cstapels/duckhouse/README.md

# duckhouse
controller for the duck house
