cstapels/duckhouse/duckboard/specificationDuck.md

Duck House Controller — Hardware Specification
Revision: 1.8 Purpose: ESP32-based controller for automated duck-house lift/door actuators, manual controls, environmental sensing, pump control, and battery monitoring.
1. System Overview
The controller operates from a nominal 12 V lead-acid battery and controls two 12 V linear actuators:
1. Lift actuator
2. Door actuator
Each actuator is controlled by an external BTS7960 / IBT-2 motor controller. Motor current does not pass through the PCB.
The PCB contains:
• ESP32U DevKit
• 12 V battery input and PCB protection
• External 5 V buck-converter interface
• Switched 5 V logic supply for the BTS7960 modules
• Four manual pushbuttons
• Three external limit switches
• Analog photosensor input
• Two travel-time adjustment potentiometers
• Battery-voltage measurement
• 1-Wire temperature sensor input
• Tank level input
• Pump control output (to an external driver)
• Status LED
• Connectors for all external devices
The ESP32's onboard regulator supplies the PCB's 3.3 V rail from the 5 V supply.
2. Battery Input and Power
J1 — Battery Input
2-pin, approximately 5.08 mm / 0.2" terminal block.
Pin
Signal
1
VBAT+
2
GND
Battery range:
• Nominal: 12 V
• Expected operating range: approximately 10.5–14.5 V
PCB Protection
Battery input sequence:
J1 → 8 A fuse → reverse-polarity protection → VBAT
The 8 A fuse protects the PCB/controller branch only.
The actuator motor power branches are separately fused and bypass the PCB.
Reverse Polarity
Use an N-channel MOSFET reverse-polarity protection arrangement.
Exact MOSFET/controller implementation remains TBD.
PCB Filtering
Provide:
• Bulk electrolytic capacitor near battery input
• Ceramic high-frequency bypass capacitor
• Optional TVS protection, value TBD
3. External 5 V Buck Converter
The 5 V supply is generated by an external buck converter.
J2 — Buck Converter
4-pin connector:
Pin
Signal
1
+5 V output
2
GND
3
VBAT input
4
ENABLE
Target:
• 5 V
• Up to approximately 2 A
Exact buck converter and ENABLE implementation TBD.
The 5 V supply powers:
• ESP32 DevKit
• BTS7960 logic supplies when enabled
• PCB 5 V output
4. ESP32
MCU
ESP32U DevKit / ESP32-WROOM-32U-class board.
The exact DevKit part will be finalized before the KiCad schematic is considered final.
The ESP32 DevKit's onboard regulator generates the 3.3 V rail.
No separate PCB 5 V-to-3.3 V regulator is required.
5. Corrected ESP32 GPIO Assignment
The following is the current baseline allocation.
Analog Inputs — ADC1
GPIO
Function
GPIO32
Battery voltage ADC
GPIO33
Lift travel-time potentiometer
GPIO36
Photosensor
GPIO39
Door travel-time potentiometer
All analog measurements use ADC1 so they remain compatible with ESP32 Wi-Fi operation.
GPIO36 and GPIO39 are input-only pins, which is acceptable for these measurements.
Motor Control
Lift
GPIO
Function
GPIO14
Lift Up / RPWM
GPIO12
Lift Down / LPWM
GPIO13
Lift Enable
Door
GPIO
Function
GPIO19
Door Open / RPWM
GPIO16
Door Close / LPWM
GPIO5
Door Enable
Each BTS7960 has its L_EN and R_EN tied together and controlled by the corresponding enable GPIO.
BTS7960 Logic Power
GPIO
Function
GPIO17
BTS7960 logic power switch
GPIO17 controls a discrete high-side 5 V switch.
High-Side Switch
27P04 P-channel MOSFET
• Source → +5 V
• Drain → MOTOR_CTRL_5V
• Gate → 30N06L drain
30N06L N-channel MOSFET
• Drain → 27P04 gate
• Source → GND
• Gate → GPIO17
Resistors:
• 100 kΩ from 27P04 gate to +5 V
• 10 kΩ from 30N06L gate to GND
Operation:
• GPIO17 LOW/floating → BTS7960 logic power OFF
• GPIO17 HIGH → BTS7960 logic power ON
The motor controllers' 12 V motor supply remains permanently connected to the external battery/motor-power wiring.
This switch controls only the BTS7960 logic supply.
6. ESP32 Boot/Strapping Pin Protection
Several application GPIOs are also ESP32 strapping pins. The PCB provides explicit external pulldowns so these signals have a predictable inactive state during reset and boot.
GPIO2 — Limit Switch Power
GPIO2 supplies power to the limit-switch circuits.
Add:
10 kΩ from GPIO2 to GND
Boot behavior:
• ESP32 reset/boot → GPIO2 LOW
• Firmware initialization → GPIO2 configured as output
• After initialization → GPIO2 driven HIGH when limit switches are being read
The limit switches therefore do not need to be powered during ESP32 startup.
GPIO5 — Door BTS7960 Enable
Add:
10 kΩ from GPIO5 to GND
This keeps the Door Enable signal LOW during reset/boot.
The BTS7960 logic supply is separately controlled by GPIO17 and remains OFF during startup.
GPIO12 — Lift BTS7960 LPWM
Add:
10 kΩ from GPIO12 to GND
This provides an explicit LOW state during reset/boot.
The BTS7960 logic supply is OFF during startup, so the motor controller cannot respond to the PWM signal during boot.
GPIO15 — Door Open Limit
The existing limit-switch input circuit already provides:
10 kΩ from GPIO15 to GND
This remains in place.
GPIO17 — BTS7960 Logic Power
The existing motor-logic power switch already provides:
10 kΩ from GPIO17 to GND
This guarantees that the 30N06L remains OFF while the ESP32 is resetting or booting.
GPIO23 — Pump Control
GPIO23 is not a strapping pin, but it is high-impedance during reset.
Add:
10 kΩ from GPIO23 to GND
This keeps the pump control signal LOW (pump OFF) during reset/boot.
Boot-State Resistor Summary
GPIO
Function
External pulldown
GPIO2
Limit-switch power
10 kΩ
GPIO5
Door BTS7960 enable
10 kΩ
GPIO12
Lift LPWM
10 kΩ
GPIO15
Door Open limit
10 kΩ
GPIO17
BTS7960 logic power
10 kΩ
GPIO23
Pump control
10 kΩ
GPIO0 is not used by the application and the ESP32 DevKit's existing BOOT circuitry should be retained.
Recommended Firmware Startup Sequence
The firmware should establish safe output states before enabling motor-controller logic:
1. ESP32 resets
2. GPIO2 remains LOW
3. GPIO5 remains LOW
4. GPIO12 remains LOW
5. GPIO14 remains LOW
6. GPIO16 remains LOW
7. GPIO19 remains LOW
8. GPIO13 remains LOW
9. GPIO17 remains LOW
10. GPIO23 remains LOW (pump OFF)
11. Configure GPIO directions and safe states
12. Initialize inputs/ADC
13. Start required communications
14. Drive GPIO17 HIGH to enable BTS7960 logic
15. Enable motor control and pump only when an intentional command is present
This ensures the motor controllers and pump driver cannot receive an unintended command during ESP32 startup.
7. Lift BTS7960 Interface
J3
Logic/control connector only.
Pin
Signal
1
MOTOR_CTRL_5V
2
GND
3
GPIO14 — Lift RPWM
4
GPIO12 — Lift LPWM
5
GPIO13 — Lift Enable
Motor power is external and does not enter the PCB.
8. Door BTS7960 Interface
J4
Logic/control connector only.
Pin
Signal
1
MOTOR_CTRL_5V
2
GND
3
GPIO19 — Door RPWM
4
GPIO16 — Door LPWM
5
GPIO5 — Door Enable
Motor power is external and does not enter the PCB.
9. Actuator Power
Two approximately 12 V linear actuators are used.
Current design target:
• Approximately 5 A specified operating current
• Approximately 6 A design maximum
• Exact startup/stall current not yet established
Each actuator receives power through its own external BTS7960.
Conceptually:
Battery → external fuse → BTS7960 → actuator
There will be no high-current actuator traces or motor connectors on the controller PCB.
Final external fuse sizes should be selected after measuring actual actuator startup/stall current and considering wire size.
10. Limit Switches
Three external limit switches are required:
1. Door Open
2. Door Close
3. Lift Close
There is no Lift Open limit switch in the current design.
Common Limit-Switch Power
GPIO2 supplies the limit-switch circuits.
GPIO2 is driven HIGH by firmware when the limit switches are being read.
Limit GPIO Assignment
GPIO
Function
GPIO15
Door Open
GPIO21
Door Close
GPIO25
Lift Close
Input Circuit
Each limit circuit uses:
GPIO2 → 470 Ω → switch wiring → limit switch → 470 Ω → sense GPIO
Each sense input has:
• 10 kΩ pulldown to GND
• 100 nF capacitor from GPIO to GND
Expected operation:
• Switch open → LOW
• Switch closed → HIGH
11. Pushbuttons
Four normally-open pushbuttons are used.
All are active HIGH.
Each button connects its GPIO to +3.3 V when pressed.
Each input has:
• External 10 kΩ pulldown to GND
• 100 nF capacitor from GPIO to GND
GPIO Assignment
GPIO
Button
GPIO34
Lift Close
GPIO35
Lift Open
GPIO18
Door Close
GPIO22
Door Open
12. Photosensor
The photosensor is an analog sensor.
Connections
• Supply → +3.3 V
• Ground → GND
• Analog output → GPIO36
No 5 V level shifting is required.
The photosensor is not powered through the BTS7960 logic-power switch.
Input filtering/protection remains TBD pending selection of the exact photosensor.
13. Travel-Time Potentiometers
Two potentiometers provide adjustable travel-time settings.
Target:
Bourns 3352E-1-105 or equivalent.
Requirements:
• 1 MΩ
• Single turn
• Through-hole
• Top-adjust
• 3 terminals
Lift Pot
• End 1 → +3.3 V
• End 2 → GND
• Wiper → GPIO33
• 100 nF wiper → GND
Door Pot
• End 1 → +3.3 V
• End 2 → GND
• Wiper → GPIO39
• 100 nF wiper → GND
Firmware should allow settling time and use multiple ADC readings/averaging.
14. Battery Voltage Measurement
Divider
• 2 MΩ from VBAT to ADC tap
• 100 kΩ from ADC tap to GND
• ADC tap → GPIO32
Nominal divider ratio:
21:1
Approximate ADC voltages:
Battery
ADC
10.5 V
0.500 V
12.0 V
0.571 V
14.5 V
0.690 V
A capacitor at the ADC tap should be considered to stabilize the measurement; exact value TBD.
15. Status LED
LED
• Blue
• SMD 3528
• 330 Ω series resistor
• Active HIGH
GPIO
GPIO4
Normal state:
OFF
Firmware uses the LED for:
• Startup indication
• Wi-Fi connection indication
• Other status indications as desired
15A. 1-Wire Temperature Sensor
A 1-Wire digital temperature sensor (DS18B20 or equivalent) is connected to GPIO26.
J13 — Temperature Sensor
3-pin connector:
Pin
Signal
1
+3.3 V
2
GPIO26 — 1-Wire DQ
3
GND
Circuit
• 4.7 kΩ pull-up from DQ to +3.3 V (2.2 kΩ if long cable; value TBD)
• 100–330 Ω series resistor between GPIO26 and J13 DQ (value TBD)
• Low-capacitance ESD/TVS diode on DQ at J13 (e.g., PESD5V0S1BL or similar)
• 100 nF decoupling capacitor between +3.3 V and GND at J13
• Optional 1–10 µF bulk capacitor at J13 for long cables
• Optional ferrite bead in the +3.3 V line to the sensor if noise is seen on long cable runs
• Avoid adding capacitance on the data line, as it slows 1-Wire edges
• Sensor is powered from the always-on +3.3 V rail (normal, non-parasitic power)
• Not powered through the BTS7960 logic-power switch
GPIO26 is not a strapping pin. Firmware uses a 1-Wire library (e.g., OneWire/DallasTemperature) with GPIO26 as the bus pin.
15B. Tank Level Input
Tank level input on GPIO27 (moved from GPIO26, which is now the 1-Wire temperature sensor).
J14 — Tank Level Input
Pin
Signal
1
+3.3 V
2
GPIO27 — Tank level
3
GND
Circuit
• Digital input (float switch or similar)
• 10 kΩ pulldown to GND
• 100 nF capacitor from GPIO27 to GND
• 330–470 Ω series resistor between connector and GPIO27
• Sensor supply from the always-on +3.3 V rail, not the switched MOTOR_CTRL_5V
• For a two-wire float switch, wire between pins 1 and 2 so the input goes HIGH when the switch closes (consistent with the pushbuttons)
• Firmware polarity (e.g., float up / tank full = HIGH) to be defined
GPIO27 is on ADC2, which is unavailable for analog reads while Wi-Fi is active. This is not a concern because the input is used digitally only. GPIO27 is not a strapping pin and has no boot-state concerns.
15C. Pump Control Output
GPIO23 provides the pump control signal (active HIGH) to an external pump driver.
J15 — Pump Control
Pin
Signal
1
GPIO23 — Pump control
2
GND
Circuit
• 10 kΩ pulldown from GPIO23 to GND, so the pump is OFF during ESP32 reset/boot
• 100–330 Ω series resistor between GPIO23 and J15 pin 1 (value TBD)
• Optional 100 nF capacitor from GPIO23 to GND
• Active HIGH: GPIO23 HIGH = pump ON, LOW = pump OFF
• Pump current does not pass through the PCB. The external driver switches the pump and has its own power wiring and fuse.
• The external driver's logic input must accept a 3.3 V signal.
GPIO23 is not a strapping pin and has no Wi-Fi conflicts.
16. 5 V Output
J11
2-pin 5 V output connector.
Pin
Signal
1
+5 V
2
GND
17. Connector Summary
Connector
Function
J1
Battery input
J2
External buck converter
J3
Lift BTS7960 logic/control
J4
Door BTS7960 logic/control
J5
Limit switches
J6
Lift Close button
J7
Lift Open button
J8
Door Close button
J9
Door Open button
J10
Photosensor
J11
5 V output
J12
Programming/debug — TBD
J13
1-Wire temperature sensor
J14
Tank level input
J15
Pump control
18. PCB Electrical Separation
Keep the following areas separated as much as practical:
High-current / noisy wiring
• Battery motor wiring
• BTS7960 motor outputs
• Actuator wiring
• Pump wiring and driver
These remain off-board.
Sensitive circuitry
• ESP32
• Battery ADC
• Photosensor ADC
• Travel potentiometer ADCs
• Pushbutton inputs
• Limit-switch inputs
• 1-Wire temperature sensor input
• Tank level input
Keep sensitive analog traces away from motor-controller wiring and switching nodes.
19. Decoupling and Filtering
Provide appropriate local bypass capacitors for:
• ESP32 5 V / 3.3 V supply
• BTS7960 logic supply connectors
• Photosensor supply
• Temperature sensor supply (J13)
• General PCB 3.3 V rail
• Battery input
Additional filtering:
• Pushbuttons: 100 nF
• Limit inputs: 100 nF
• Travel pots: 100 nF
• Tank level input: 100 nF
• Battery ADC: capacitor TBD
• Photosensor: filtering TBD
20. Current GPIO Map — MASTER TABLE
GPIO
Function
Type
2
Limit switch power
Output / strapping
4
Status LED
Output
5
Door BTS7960 enable
Output / strapping
12
Lift down / LPWM
Output / strapping
13
Lift enable
Output
14
Lift up / RPWM
Output
15
Door Open limit
Input / strapping
16
Door close / LPWM
Output
17
BTS7960 logic power
Output
18
Door Close button
Input
19
Door open / RPWM
Output
21
Door Close limit
Input
22
Door Open button
Input
23
Pump control
Output
25
Lift Close limit
Input
26
1-Wire temperature sensor
I/O
27
Tank level input
Input
32
Battery voltage
ADC1
33
Lift travel pot
ADC1
34
Lift Close button
Input
35
Lift Open button
Input
36
Photosensor
ADC1
39
Door travel pot
ADC1
GPIO6–11 remain reserved for ESP32 flash operation.
21. Open Design Items
Before PCB fabrication, finalize:
1. Exact ESP32U DevKit module
2. Reverse-polarity MOSFET circuit
3. Battery TVS selection
4. Battery input capacitor values
5. Exact external 5 V buck converter
6. Buck ENABLE behavior
7. Exact BTS7960/IBT-2 module
8. BTS7960 connector type and pinout
9. External actuator fuse ratings
10. Measured actuator startup/stall current
11. Exact photosensor
12. Photosensor filtering/protection
13. Battery ADC filter capacitor
14. Exact limit-switch connector
15. Exact pushbutton connectors
16. Programming/debug connector
17. PCB dimensions and mounting holes
18. Enclosure/weatherproofing requirements
19. Final ESP32 boot/strapping-pin review
20. Final PCB creepage/clearance and trace-width review
21. Exact temperature sensor (probe vs. board-mount, waterproofing)
22. Temperature sensor connector and cable length (sets pull-up value)
23. Exact tank level sensor and connector type
24. Tank level polarity (full = HIGH or LOW)
25. Pump specification (voltage, running/stall current)
26. External pump driver module, its 3.3 V logic compatibility and polarity (active HIGH assumed), and external fuse rating
27. Pump/tank-level interlock behavior (e.g., pump forced OFF when tank is full)
22. Revision History
Rev 1.8
• Added 1-Wire temperature sensor on GPIO26 (J13) with pull-up, series resistor, ESD protection, and decoupling
• Added tank level input on GPIO27 (J14), digital input with pulldown, filter capacitor, and series resistor
• Added pump control output on GPIO23 (J15) with 10 kΩ pulldown and series resistor, driving an external pump driver
• Added GPIO23 to boot-state resistor summary and firmware startup sequence
• Removed stray "21. Level input" entry (previously assigned GPIO26)
• Updated system overview, connector summary, master GPIO table, filtering list, and open design items
Rev 1.7
• Added explicit 10 kΩ GPIO2 pulldown
• Added explicit 10 kΩ GPIO5 pulldown
• Added explicit 10 kΩ GPIO12 pulldown
• Retained existing 10 kΩ GPIO15 pulldown
• Retained existing 10 kΩ GPIO17 pulldown
• Added dedicated ESP32 boot/strapping-pin section
• Added recommended firmware startup sequence
• Clarified that BTS7960 logic power remains OFF during ESP32 startup
