cstapels/duckhouse/duckboard/DuckControlBoard/duckboardAI.kicad_pcb

## KiCad design duckboard/DuckControlBoard/duckboardAI.kicad_pcb (2026-11-01)

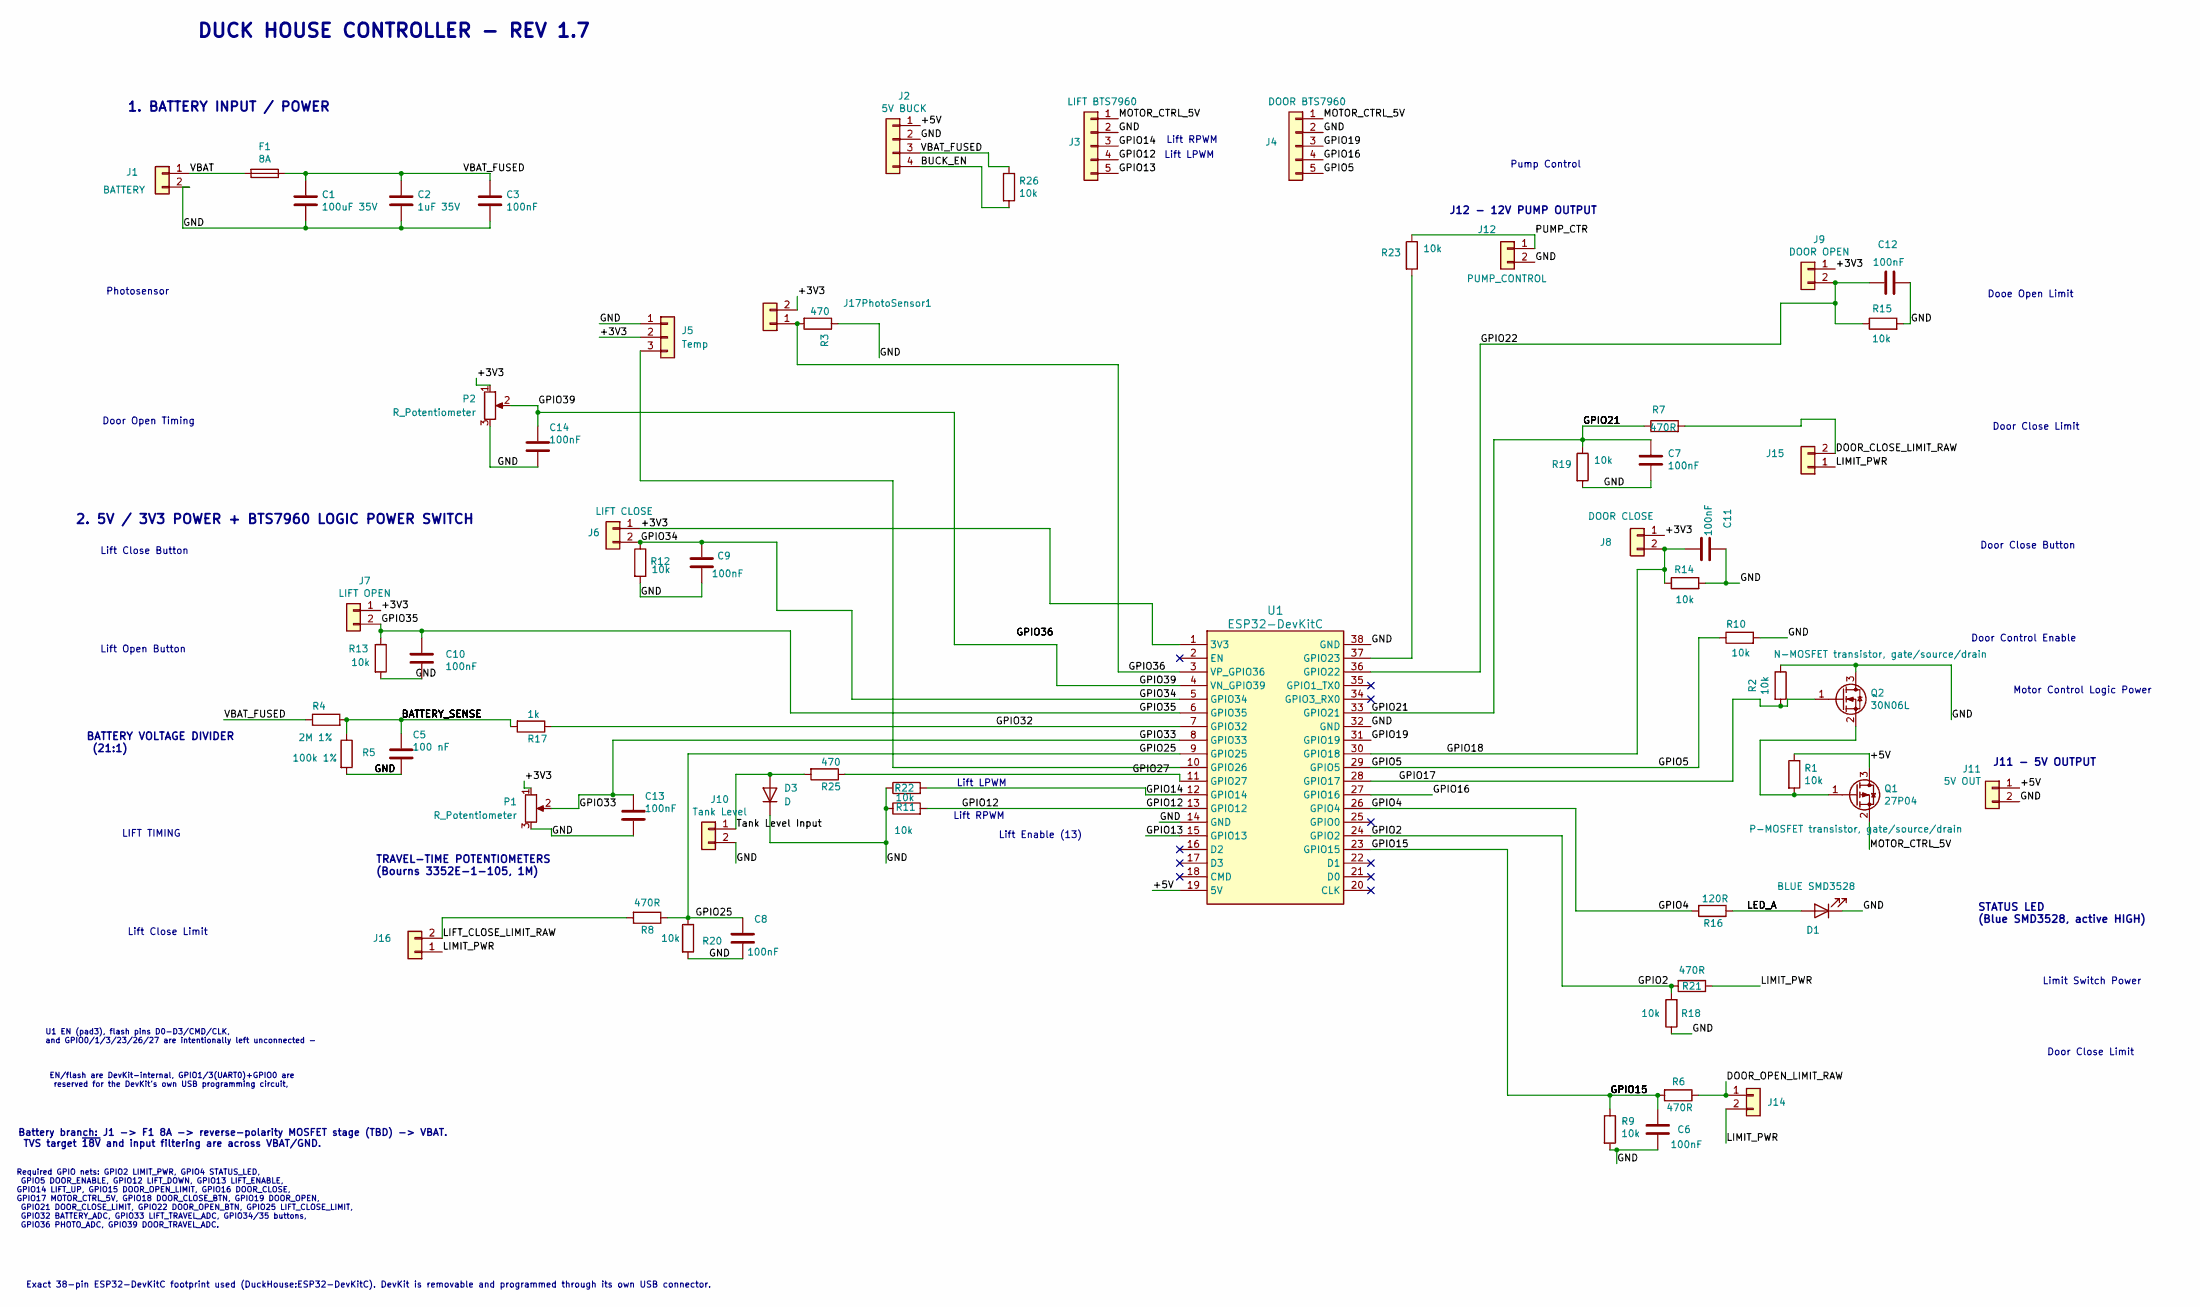
[picture p1: schematic duckboardAI.kicad_sch]

Parts:
C1: 100uF 35V; C_0805_2012Metric
C2: 1uF 35V; C_0805_2012Metric
C3, C6, C7, C8, C9, C10, C11, C12, C13, C14: 100nF; C_0805_2012Metric
C5: 100 nF; C_0805_2012Metric
D1: BLUE SMD3528; LED_Everlight-SMD3528_3.5x2.8mm_67-21ST
D3: D; D_0805_2012Metric
F1: 8A; Fuseholder_Cylinder-5x20mm_Schurter_0031_8201_Horizontal_Op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
J1: BATTERY; TerminalBlock_MaiXu_MX126-5.0-02P_1x02_P5.00mm
J2: 5V BUCK; PinHeader_1x04_P2.54mm_Vertical
J3: LIFT BTS7960; JST_EH_B5B-EH-A_1x05_P2.50mm_Vertical
J4: DOOR BTS7960; JST_EH_B5B-EH-A_1x05_P2.50mm_Vertical
J5: Temp; JST_EH_B3B-EH-A_1x03_P2.50mm_Vertical
J6: LIFT CLOSE; JST_EH_S2B-EH_1x02_P2.50mm_Horizontal
J7: LIFT OPEN; JST_EH_S2B-EH_1x02_P2.50mm_Horizontal
J8: DOOR CLOSE; JST_EH_S2B-EH_1x02_P2.50mm_Horizontal
J9: DOOR OPEN; JST_EH_S2B-EH_1x02_P2.50mm_Horizontal
J10: Tank Level; JST_EH_S2B-EH_1x02_P2.50mm_Horizontal
J11: 5V OUT; JST_EH_S2B-EH_1x02_P2.50mm_Horizontal
J12: PUMP_CONTROL; TerminalBlock_MaiXu_MX126-5.0-02P_1x02_P5.00mm
J14: DOOR_OPEN_LIMIT; JST_EH_S2B-EH_1x02_P2.50mm_Horizontal
J15: DOOR_CLOSE_LIMIT; JST_EH_S2B-EH_1x02_P2.50mm_Horizontal
J16: LIFT_CLOSE_LIMIT; JST_EH_S2B-EH_1x02_P2.50mm_Horizontal
J17PhotoSensor1: Conn_01x02; TerminalBlock_MaiXu_MX126-5.0-02P_1x02_P5.00mm
P1, P2: R_Potentiometer; Potentiometer_Piher_T-16L_Single_Vertical_Hole
Q1: 27P04; TO-220-3_Horizontal_TabUp
Q2: 30N06L; TO-220-3_Horizontal_TabUp
R1, R2, R9, R10, R11, R12, R13, R14, R15, R18, R19, R20, R22, R23, R26: 10k; R_0603_1608Metric
R3, R25: 470; R_0603_1608Metric
R4: 2M 1%; R_0603_1608Metric
R5: 100k 1%; R_0603_1608Metric
R6, R7, R8, R21: 470R; R_0603_1608Metric
R16: 120R; R_0603_1608Metric
R17: 1k; R_0603_1608Metric
U1: ESP32-DevKitC

Connections:
/+3V3: J5.2, J6.1, J7.1, J8.1, J9.1, J17PhotoSensor1.2, P1.1, P2.1, U1.1 (3V3)
/+5V: J2.1, J11.1, Q1.3 (D), R1.1, U1.19 (5V)
/BATTERY_SENSE: C5.1, R4.2, R5.1, R17.2
/BUCK_EN: J2.4, R26.2
/DOOR_CLOSE_LIMIT_RAW: J15.2, R7.2
/DOOR_OPEN_LIMIT_RAW: J14.1, R6.1
/GND: C1.2, C2.2, C3.2, C5.2, C6.2, C7.2, C8.2, C9.2, C10.2, C11.1, C12.2, C13.2, C14.2, D1.1 (K), D3.1 (K), J1.2, J2.2, J3.2, J4.2, J5.1, J10.2, J11.2, J12.2, P1.3, P2.3, Q2.3 (D), R2.1, R3.1, R5.2, R9.2, R10.2, R11.1, R12.2, R13.2, R14.2, R15.2, R18.1, R19.2, R20.2, R22.1, U1.14 (GND), U1.32 (GND), U1.38 (GND)
/GPIO2: R18.2, R21.2, U1.24 (GPIO2)
/GPIO4: R16.2, U1.26 (GPIO4)
/GPIO5: J4.5, R10.1, U1.29 (GPIO5)
/GPIO12: J3.4, R11.2, U1.13 (GPIO12)
/GPIO13: J3.5, U1.15 (GPIO13)
/GPIO14: J3.3, R22.2, U1.12 (GPIO14)
/GPIO15: C6.1, R6.2, R9.1, U1.23 (GPIO15)
/GPIO16: J4.4, U1.27 (GPIO16)
/GPIO17: Q2.1 (G), R2.2, U1.28 (GPIO17)
/GPIO18: C11.2, J8.2, R14.1, U1.30 (GPIO18)
/GPIO19: J4.3, U1.31 (GPIO19)
/GPIO21: C7.1, R7.1, R19.1, U1.33 (GPIO21)
/GPIO22: C12.1, J9.2, R15.1, U1.36 (GPIO22)
/GPIO25: C8.1, R8.1, R20.1, U1.9 (GPIO25)
/GPIO27: R25.1, U1.11 (GPIO27)
/GPIO32: R17.1, U1.7 (GPIO32)
/GPIO33: C13.1, P1.2, U1.8 (GPIO33)
/GPIO34: C9.1, J6.2, R12.1, U1.5 (GPIO34)
/GPIO35: C10.1, J7.2, R13.1, U1.6 (GPIO35)
/GPIO36: J17PhotoSensor1.1, R3.2, U1.3 (VP_GPIO36)
/GPIO39: C14.1, P2.2, U1.4 (VN_GPIO39)
/LED_A: D1.2 (A), R16.1
/LIFT_CLOSE_LIMIT_RAW: J16.2, R8.2
/LIMIT_PWR: J14.2, J15.1, J16.1, R21.1
/MOTOR_CTRL_5V: J3.1, J4.1, Q1.2 (S)
/PUMP_CTR: J12.1, R23.1
/Tank Level Input: D3.2 (A), J10.1, R25.2
/VBAT: F1.2, J1.1
/VBAT_FUSED: C1.1, C2.1, C3.1, F1.1, J2.3, R4.1, R26.1
unnamed: J5.3, U1.10 (GPIO26)
unnamed: Q1.1 (G), Q2.2 (S), R1.2
unnamed: R23.2, U1.37 (GPIO23)

Notes on the sheet:
Lift Open Button
BATTERY VOLTAGE DIVIDER (21:1)
Lift RPWM
Lift LPWM
DUCK HOUSE CONTROLLER - REV 1.7
J11 - 5V OUTPUT
Door Close Limit
TRAVEL-TIME POTENTIOMETERS (Bourns 3352E-1-105, 1M)
Lift Close Button
Battery branch: J1 -> F1 8A -> reverse-polarity MOSFET stage (TBD) -> VBAT. TVS target ~{18V} and input filtering are across VBAT/GND.
EN/flash are DevKit-internal, GPIO1/3(UART0)+GPIO0 are reserved for the DevKit's own USB programming circuit,
1. BATTERY INPUT / POWER
STATUS LED (Blue SMD3528, active HIGH)
LIFT TIMING
Motor Control Logic Power
Door Control Enable
Lift Enable (13)
J12 - 12V PUMP OUTPUT
2. 5V / 3V3 POWER + BTS7960 LOGIC POWER SWITCH
Door Close Button
Limit Switch Power
Exact 38-pin ESP32-DevKitC footprint used (DuckHouse:ESP32-DevKitC). DevKit is removable and programmed through its own USB connector.
Pump Control
Door Open Timing
Lift Close Limit
Required GPIO nets: GPIO2 LIMIT_PWR, GPIO4 STATUS_LED, GPIO5 DOOR_ENABLE, GPIO12 LIFT_DOWN, GPIO13 LIFT_ENABLE, GPIO14 LIFT_UP, GPIO15 DOOR_OPEN_LIMIT, GPIO16 DOOR_CLOSE, GPIO17 MOTOR_CTRL_5V, GPIO18 DOOR_CLOSE_BTN, GPIO19 DOOR_OPEN, GPIO21 DOOR_CLOSE_LIMIT, GPIO22 DOOR_OPEN_BTN, GPIO25 LIFT_CLOSE_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
U1 EN (pad3), flash pins D0-D3/CMD/CLK, and GPIO0/1/3/23/26/27 are intentionally left unconnected -
Dooe Open Limit
Photosensor

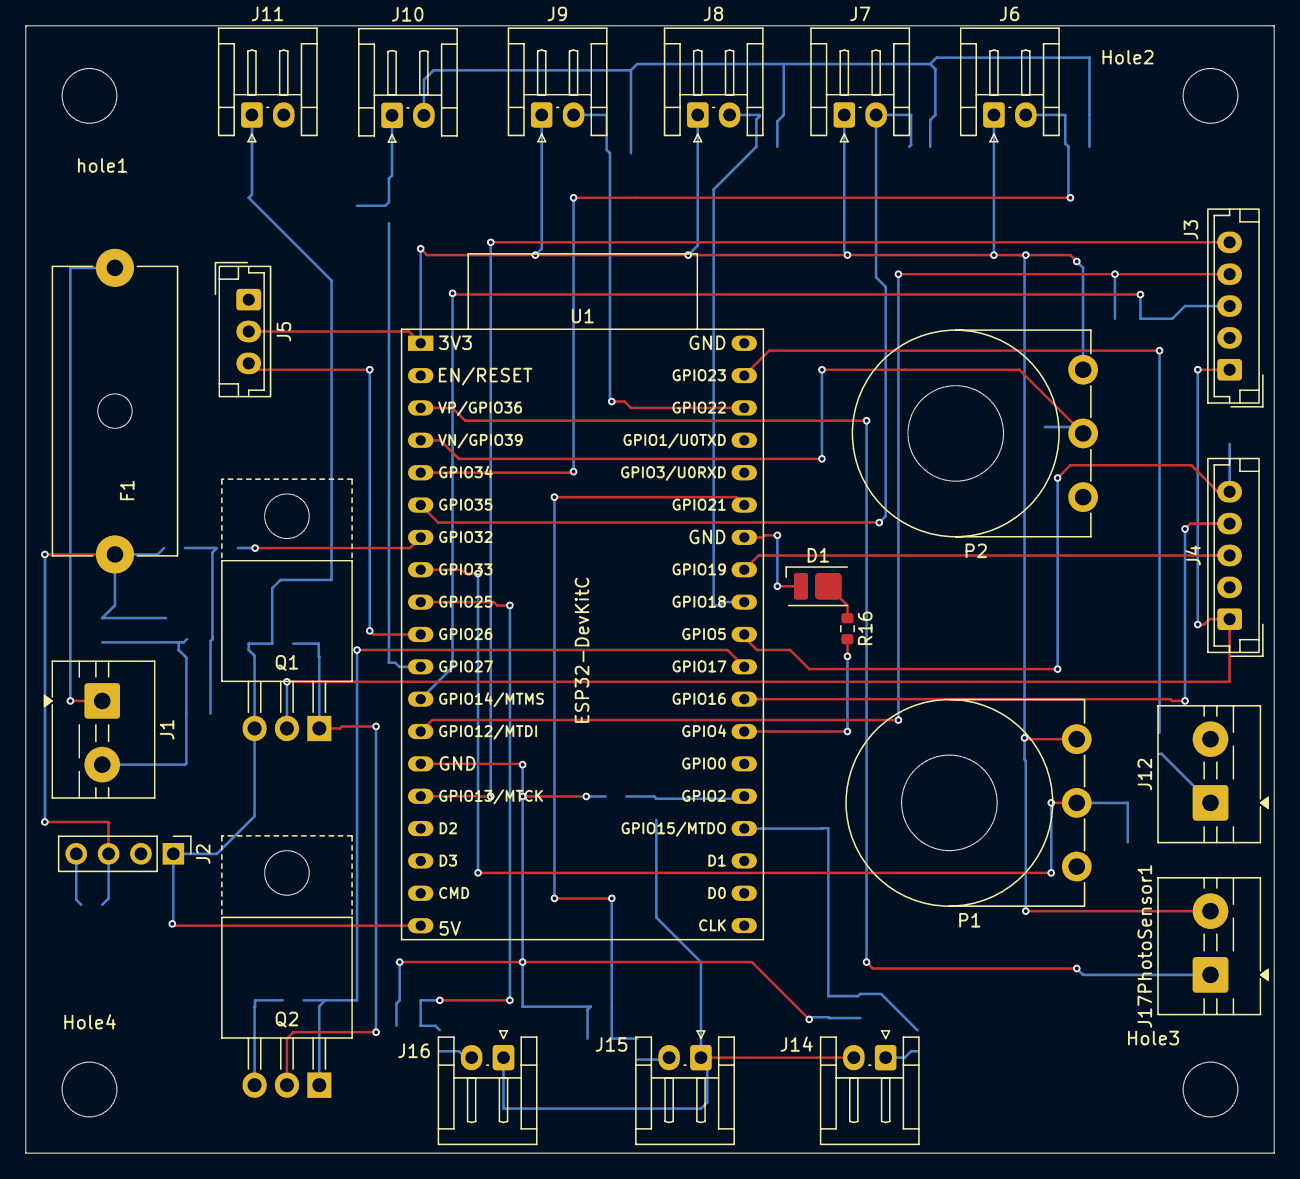
[picture p2: board duckboardAI.kicad_pcb from above]

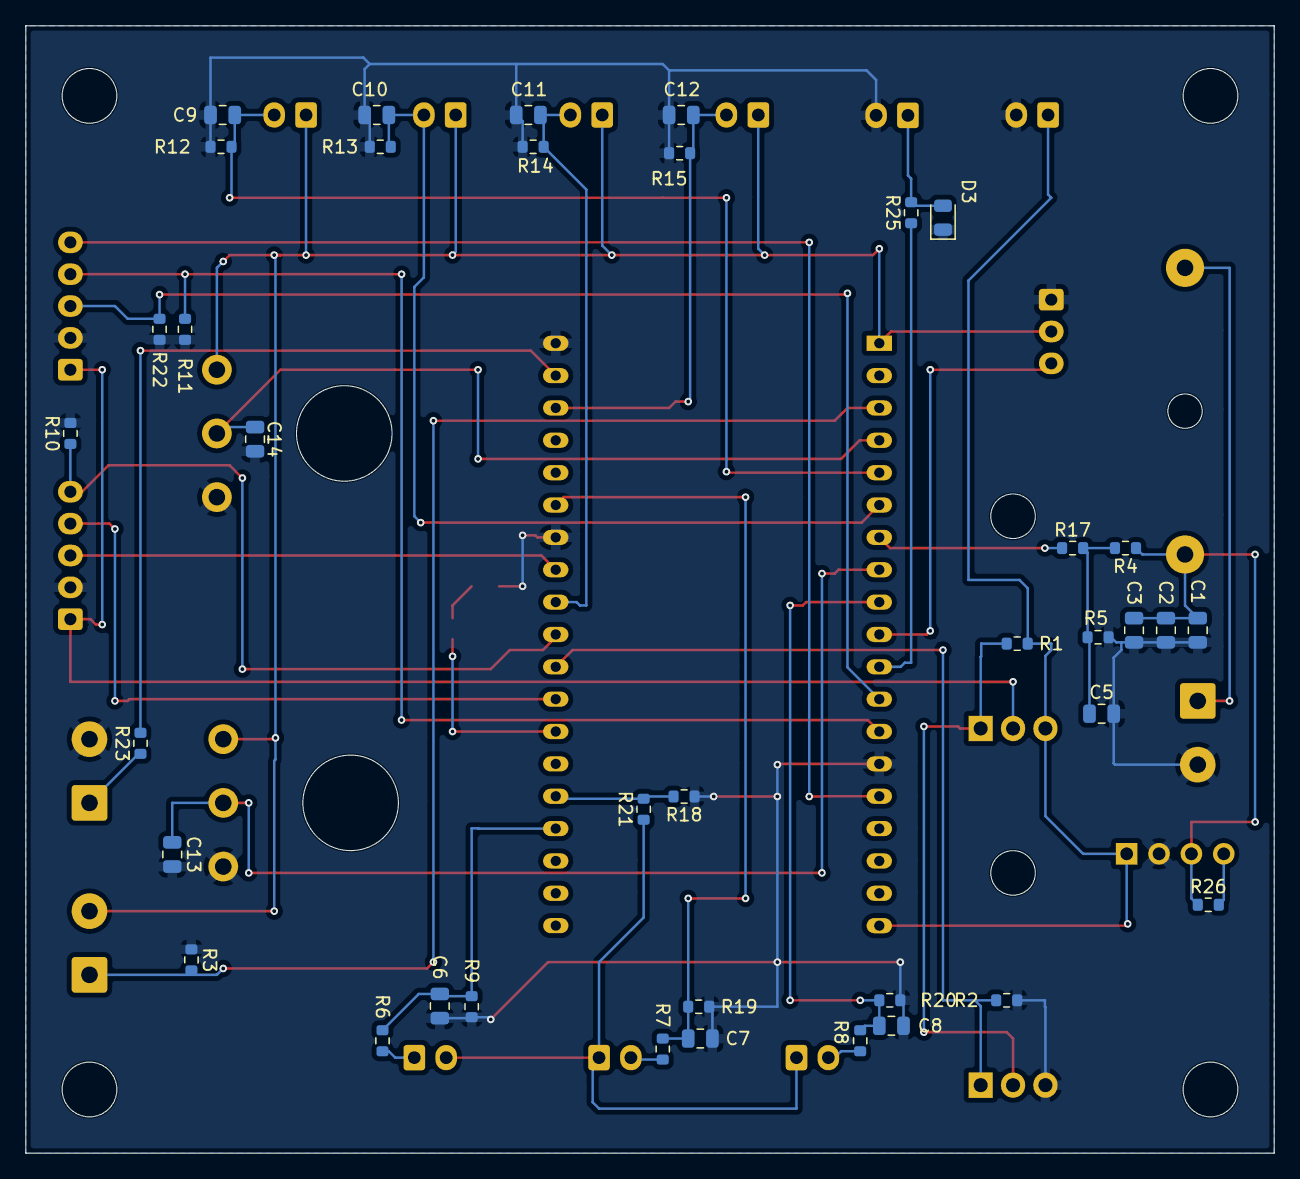
[picture p3: board duckboardAI.kicad_pcb from below]

Board: 2 copper layers, 98.0 x 88.5 mm, 66 parts (38 on the bottom side), 39 nets.

Other parts of the board:
Hole2, Hole3, Hole4: MountingHole_4.3mm_M4
hole1: MountingHole_4.3mm_M4
