cstapels/duckhouse/duckboard/DuckHouseController_Rev1_8_wiring_pass1/DuckHouseController_Rev1_8/DuckHouseController_Rev1_8.sch

## KiCad design duckboard/DuckHouseController_Rev1_8_wiring_pass1/DuckHouseController_Rev1_8/DuckHouseController_Rev1_8.sch (2026-09-21)

Schematic: DuckHouseController_Rev1_8.sch

Parts:
C1: 100uF 35V
C2: 1uF 35V
C3: 100nF
D2: BLUE
F1: 8A
J1: BATTERY
J2: 5V BUCK
J3: LIFT BTS7960
J4: DOOR BTS7960
J5: LIMIT SWITCHES
J6: LIFT CLOSE
J7: LIFT OPEN
J8: DOOR CLOSE
J9: DOOR OPEN
Q1: 27P04
Q2: 30N06L
R1: 100k
R2, R12, R13, R17, R22: 10k
R21: 470R
R37: 330R
U1: ESP32-DevKitC

Notes on the sheet:
DUCK HOUSE CONTROLLER — REV 1.7
WIRING PASS 1 — exact ESP32-DevKitC pin mapping installed
1. BATTERY INPUT / POWER
Battery branch: J1 → F1 8A → reverse-polarity MOSFET stage (TBD) → VBAT. TVS target ~18V and input filtering are across VBAT/GND.
Actuator motor power bypasses PCB fuse: battery → external fuse → BTS7960 motor controller → actuator.
2. 5V / 3V3 POWER + BTS7960 LOGIC POWER SWITCH
External 5V/2A buck. ESP32 DevKit is powered from +5V/VIN and supplies +3V3 via its onboard regulator.
GPIO17 HIGH turns BTS7960 logic +5V ON; LOW/reset keeps it OFF. Motor power remains direct battery.
3. BTS7960 LOGIC INTERFACES
J3 pins: 1 MOTOR_CTRL_5V, 2 GND, 3 GPIO14 LIFT_UP, 4 GPIO12 LIFT_DOWN, 5 GPIO13 ENABLE
J4 pins: 1 MOTOR_CTRL_5V, 2 GND, 3 GPIO19 DOOR_OPEN, 4 GPIO16 DOOR_CLOSE, 5 GPIO5 ENABLE
4. LIMIT SWITCHES
J5: 1 LIMIT_PWR, 2 DOOR_OPEN_LIMIT, 3 DOOR_CLOSE_LIMIT, 4 LIFT_CLOSE_LIMIT
Each limit path: LIMIT_PWR → switch → 470R → sense GPIO. Each sense has 10k pulldown + 100nF to GND. GPIO2 has 10k pulldown.
5. LOCAL PUSHBUTTONS — ACTIVE HIGH
Each button: NO to +3V3; 10k external pulldown + 100nF GPIO-to-GND. Signals: J6 GPIO34, J7 GPIO35, J8 GPIO18, J9 GPIO22.
6. ANALOG INPUTS
J10 photosensor: +3V3/GND/PHOTO_SENSE → 1k → GPIO36 ADC1, 100nF to GND. P1/P2 1M linear pots: +3V3/wiper/GND to GPIO33/GPIO39, 100nF from wiper to GND.
7. BATTERY ADC
VBAT → 2.0M 1% → BATTERY_SENSE → 100k 1% → GND; 100nF at sense; 1k series to GPIO32 ADC1. Divider ≈21:1.
8. ESP32 DEVKITC
Exact 38-pin ESP32-DevKitC footprint used. DevKit is removable and programmed through its own USB connector.
GPIO NET ASSIGNMENTS: GPIO2 LIMIT_PWR, GPIO4 STATUS_LED, GPIO5 DOOR_ENABLE, GPIO12 LIFT_DOWN, GPIO13 LIFT_ENABLE, GPIO14 LIFT_UP, GPIO15 DOOR_OPEN_LIMIT, GPIO16 DOOR_CLOSE, GPIO17 MOTOR_CTRL_5V, GPIO18 DOOR_CLOSE_BTN, GPIO19 DOOR_OPEN, GPIO21 DOOR_CLOSE_LIMIT, GPIO22 DOOR_OPEN_BTN, GPIO25 LIFT_CLOS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
ESP32U DEVKITC — SIGNAL / POWER CONNECTIONS
All controller signals are assigned by net label at the ESP32 pins. Unused DevKit pins are intentionally left NC.
WIRING PASS 1 COMPLETE: ESP32 GPIO net names now terminate directly at the exact DevKit pin numbers.
Next pass: complete the RC input networks, power symbols, reverse-polarity MOSFET, TVS, and ERC power flags.
Important: GPIO2 is LIMIT_PWR; GPIO17 is MOTOR_CTRL_EN; MOTOR_CTRL_5V is the switched BTS7960 logic rail.
Status LED: GPIO4 → 330R → blue LED → GND
Enable/direction pulldowns: R13 GPIO5, R17 GPIO17, R12 GPIO12
