cstapels/duckhouse/duckHouseControl/include/utilities.h

#pragma once 

void blinkX(int numTimes, int delayTime);
int startDoor(int openClose);
int stopDoor();
int startLift(int openClose);
int stopLift();
int checkLimit(int direction);
void getTimeLimits();
