cstapels/duckhouse/(commit log)

2024-12-14 add temperature measurement routine
2024-12-15 deploy changes and init correct
    [duckTemp.ino.ino]
2025-04-10 Measure two dht sensors in the garage for baby ducks
    title says it all
2025-11-20 update connection
    growing delay time plus reset after 9
    [duckTemp.ino]
2025-11-30 changed try counter
    seems like the cable was bad
2025-12-20 larger buttons for mobile, fix missign iframes,
2025-12-20 include battery plot
2026-09-21 duckboard stuffs
    [DuckHouseController_Rev1_7 (1).kicad_sch, DuckHouseController_Rev1_7 (1).sch, DuckHouseController_Rev1_8.sch]
2026-09-28 more board updates
    [DuckHouseController_Rev1_7.kicad_sch, DuckHouseController_Rev1_7.sch, duckboardAI.kicad_pcb, duckboardAI.kicad_sch]
2026-10-07 more board changes
    [duckboardAI.kicad_pcb, duckboardAI.kicad_sch]
2026-10-09 schematic and board work
    [duckboardAI.kicad_pcb, duckboardAI.kicad_sch]
2026-11-09 couple new versions of the code
